khomyakova228-cell/pulse-oximeter/pulse_oximeter.kicad_pcb

## KiCad design pulse_oximeter.kicad_pcb (2026-10-13)

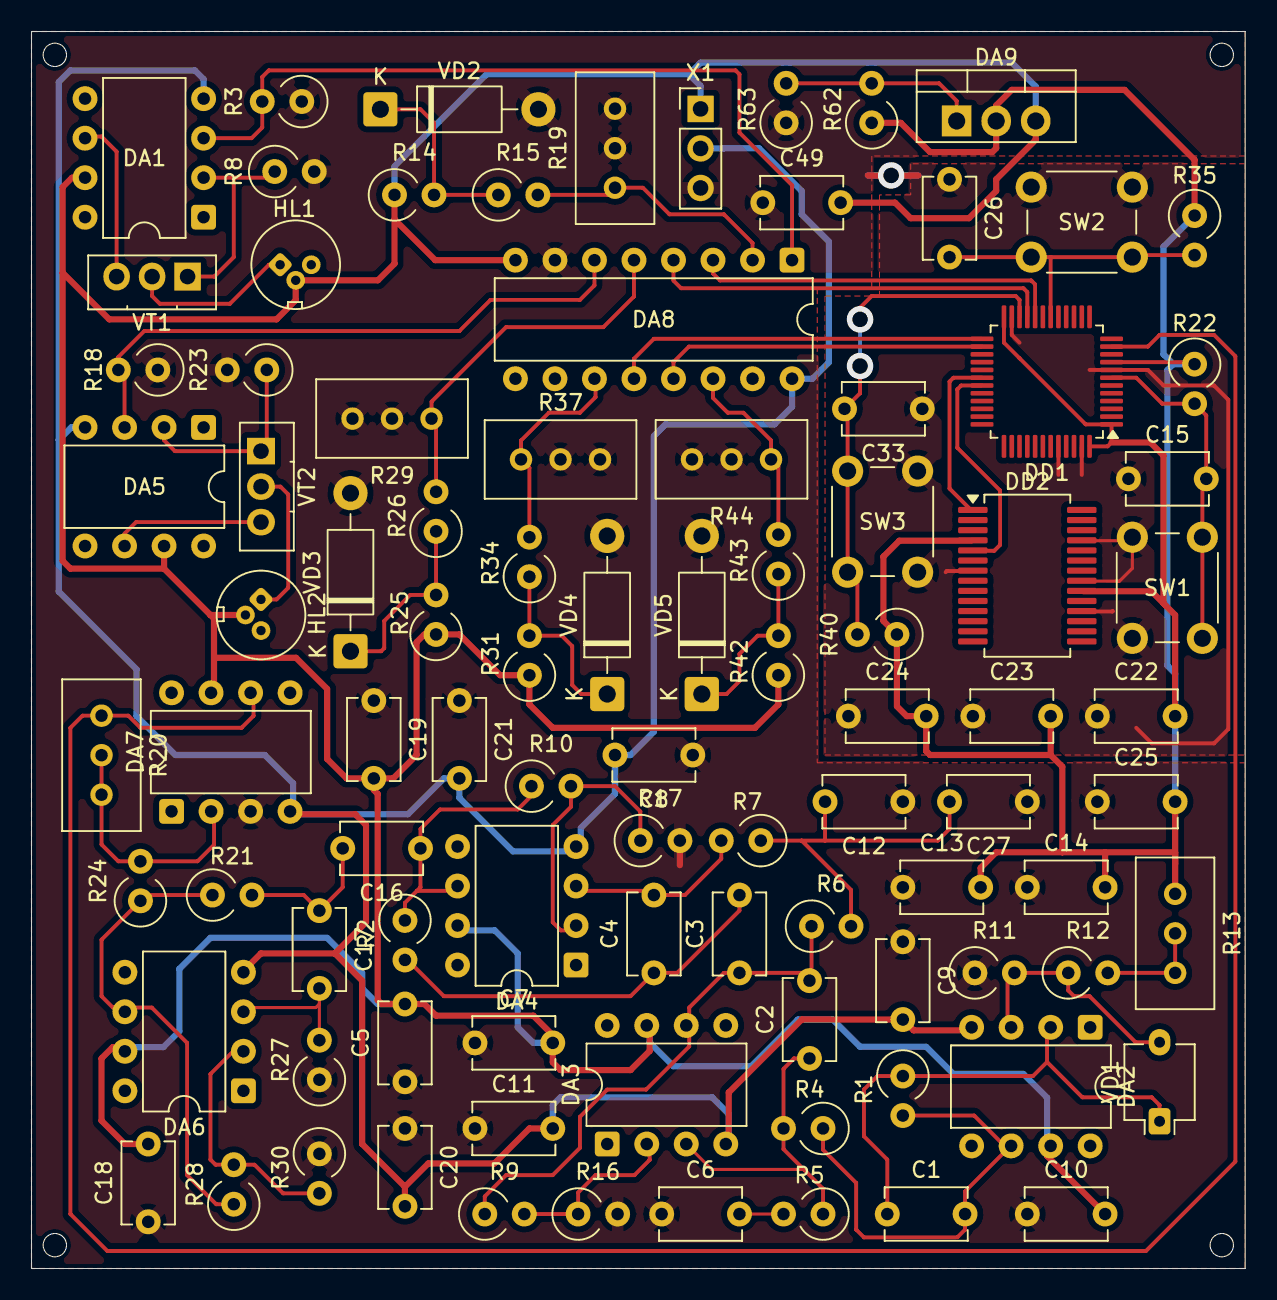
[picture p15: board pulse_oximeter.kicad_pcb from above]

Board: 2 copper layers, 78.0 x 79.5 mm, 93 parts (0 on the bottom side), 49 nets.

Parts:
C1, C2, C3, C4, C5, C6, C7, C8, C9, C10, C11, C12, C13, C14, C15, C16, C17, C18, C19, C20, C21, C22, C23, C24, C25, C26, C27, C33, C49: 100n; C_Disc_D5.1mm_W3.2mm_P5.00mm
DA1, DA2, DA3, DA4, DA5, DA6, DA7: OPA340P; DIP-8_W7.62mm
DA8: КР590КН2; DIP-16_W7.62mm
DA9: LM1117T-ADJ; TO-220-3_Vertical
DD1: STM32F030C8T6; LQFP-48_7x7mm_P0.5mm
DD2: FT232RL; SSOP-28_5.3x10.2mm_P0.65mm
HL1, HL2: TSAL6200; LaserDiode_TO18-D5.6-3
R1, R4, R5, R6, R7, R11, R12, R18, R21, R23, R28, R62: 10k; R_Axial_DIN0309_L9.0mm_D3.2mm_P2.54mm_Vertical
R2, R3, R9, R10, R16, R17, R22, R35, R40: 22k; R_Axial_DIN0309_L9.0mm_D3.2mm_P2.54mm_Vertical
R8, R14, R24, R25, R27, R30, R31, R42, R63: 390; R_Axial_DIN0309_L9.0mm_D3.2mm_P2.54mm_Vertical
R13, R19, R20, R29, R37, R44: 10k; Potentiometer_Bourns_3296W_Vertical
R15, R26, R34, R43: 2.2k; R_Axial_DIN0309_L9.0mm_D3.2mm_P2.54mm_Vertical
SW1, SW2, SW3: B3F-1000; SW_PUSH_6mm
VD1: BPW34; Osram_DIL2_4.3x4.65mm_P5.08mm
VD2, VD3, VD4, VD5: 5V1; D_DO-41_SOD81_P10.16mm_Horizontal
VT1, VT2: BD139-16; TO-126-3_Vertical
X1: Conn_01x03; PinHeader_1x03_P2.54mm_Vertical

Connections:
/ADC_IN: DA7.6, DD1.11 (PA1), R20.3
/BTN1: C26.2, DD1.18 (PB0), R35.2, SW2.2
/BTN2: C33.2, DD1.22 (PB11), R40.2, SW3.2
/HPF_OUT: DA6.6, R21.1, R24.1, R28.1
/LED1_REF: DA1.3, DA8.1 (OUT1), R3.2
/LED2_REF: DA5.3, DA8.6 (OUT2), R18.2
/LPF_OUT: C2.2, C3.1, DA3.6, R6.1, R9.1
/NOTCH_OUT: C16.1, DA4.6, R2.1, R10.1
/NRST: C15.2, DD1.7 (RST), R22.2, SW1.2
/PD_A: DA2.3, R11.2, R12.1, VD1.2 (A)
/PD_K: C1.1, DA2.2, R1.1, VD1.1 (K)
/REF1: DA8.2 (IN1), R15.2, R19.3
/REF2: DA8.5 (IN2), R26.2, R29.3
/REF3: DA8.11 (IN3), R34.2, R37.3
/REF4: DA8.14 (IN4), R43.2, R44.3
/SW_D1: DA8.3 (D1), DD1.20 (PB2)
/SW_D2: DA8.4 (D2), DD1.21 (PB10)
/SW_D3: DA8.12 (D3), DD1.25 (PB12)
/SW_D4: DA8.13 (D4), DD1.26 (PB13)
/TIA_OUT: C1.2, DA2.6, R1.2, R4.1
/UART_RX: DD1.31 (PA10), DD2.5 (RXD)
/UART_TX: DD1.30 (PA9), DD2.1 (TXD)
GND: C5.1, C6.1, C7.1, C8.1, C9.1, C10.1, C11.1, C12.1, C13.1, C14.1, C15.1, C18.1, C19.1, C20.1, C21.1, C22.1, C23.1, C24.1, C25.1, C26.1, C27.1, C33.1, C49.1, DA7.3, DA8.7 (0V), DD1.8 (VSSA), DD1.23 (VSS), DD1.44 (BOOT0), DD1.47 (VSS), DD2.7 (GND), DD2.18 (GND), DD2.21 (GND), DD2.25 (AGND), R3.1, R8.2, R11.1, R16.2, R17.2, R18.1, R19.1, R19.2, R23.2, R27.1, R29.1, R29.2, R30.1, R37.1, R37.2, R44.1, R44.2, R63.1, SW1.1, SW2.1, SW3.1, VD2.2 (A), VD3.2 (A), VD4.2 (A), VD5.2 (A), X1.3
unnamed: C2.1, DA3.3, R4.2, R5.1
unnamed: C3.2, C4.1, R2.2
unnamed: C4.2, DA4.3, R7.2
unnamed: C6.2, R5.2
unnamed: C12.2, C27.2, R6.2, R7.1
unnamed: C16.2, C17.1, R21.2
unnamed: C17.2, DA6.3, R27.2
unnamed: DA3.2, R9.2, R16.1
unnamed: DA4.2, R10.2, R17.1
unnamed: DA6.2, R28.2, R30.2
unnamed: DA7.2, R20.1, R20.2, R24.2
unnamed: DA9.1 (ADJ), R62.2, R63.2
unnamed: HL1.1 (K), VT1.2 (C)
unnamed: HL2.1 (K), VT2.2 (C)
unnamed: R12.2, R13.1, R13.2
unnamed: R14.2, R15.1, VD2.1 (K)
unnamed: R25.2, R26.1, VD3.1 (K)
unnamed: R31.2, R34.1, VD4.1 (K)
unnamed: R42.2, R43.1, VD5.1 (K)
unnamed: DA1.6, VT1.3 (B)
unnamed: DA1.2, R8.1, VT1.1 (E)
unnamed: DA5.6, VT2.3 (B)
unnamed: DA5.2, R23.1, VT2.1 (E)
А: C13.2, C14.2, C22.2, C23.2, C24.2, C25.2, DA9.2 (OUT), DD1.1 (VDD), DD1.9 (VDDA), DD1.24 (VDD), DD1.48 (VDD), DD2.4 (VCCIO), DD2.20 (VCC), R13.3, R22.1, R35.1, R40.1, R62.1
Б: C5.2, C7.2, C10.2, C18.2, C19.2, C49.2, DA1.7 (+U), DA2.7 (+U), DA3.7 (+U), DA4.7 (+U), DA5.7 (+U), DA6.7 (+U), DA7.7 (+U), DA8.8 (+U), DA9.3 (IN), HL1.2 (A), HL2.2 (A), R14.1, R25.1, R31.1, R42.1, X1.1
В: C8.2, C9.2, C11.2, C20.2, C21.2, DA1.4 (-U), DA2.4 (-U), DA3.4 (-U), DA4.4 (-U), DA5.4 (-U), DA6.4 (-U), DA7.4 (-U), DA8.16 (-U), X1.2
