khomyakova228-cell/pulse-oximeter/(commit log)

2026-10-08 Проект «Пульсоксиметр»: рамка ГОСТ, классы цепей, партномера, сабмодуль библиотеки, скрипты выпуска, отчёт
    Claude-Session: https://claude.ai/code/session_01FsJMMwHQ3FuEgyASHhQBd4
    [pulse_oximeter.kicad_pcb, pulse_oximeter.kicad_sch]
2026-10-08 Посадочные места в библиотеке (GOST_FP), правила DRC «Резонит», отчёт по пунктам задания
    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
    [pulse_oximeter.kicad_pcb, pulse_oximeter.kicad_sch]
2026-10-13 Схема переведена на ГОСТ-УГО (R, C, подстроечные, светодиоды, фотодиод, стабилитроны, транзисторы, общий провод); метки основных цепей; классы цепей по меткам
    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
    [pulse_oximeter.kicad_sch]
2026-10-13 Итоговая версия проекта: схема и плата после трассировки, все УГО и посадочные места из библиотеки, ERC/DRC без ошибок, STEP в скрипте, отчёт обновлён
    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
    [pulse_oximeter.kicad_pcb, pulse_oximeter.kicad_sch]
2026-10-13 Отчёт: раздел о скрипте сокращён до шагов
    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
2026-10-13 Отчёт: убран раздел о публикации, добавлен итог по пунктам задания
    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
